freitz85/Victor9000-RAM/README.md

# Victor9000-RAM

The Victor9000-RAM is a modern RAM expansion card for the Victor 9000 computer that extends RAM to the maximum 896k and additionally provides a battery-backed-up real-time clock.

Jumper JP1 open is for use on a 256k motherboard, and JP1 closed is for a 128k motherboard.
