freitz85/Victor9000-RAM/IC_Maxim_DS1315-5+/eec.models/Maxim_-_DS1315-5+.step

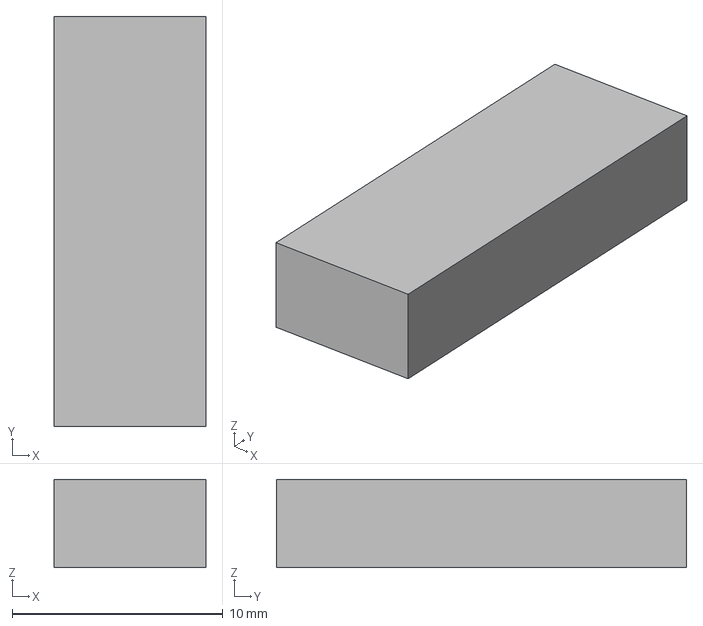
[picture p1: CAD file, 2021-12-12]
IC_Maxim_DS1315-5+/eec.models/Maxim_-_DS1315-5+.step
7.20 x 19.4 x 4.19 mm
