freitz85/Victor9000-RAM/Victor9000-RAM-Clock.pdf

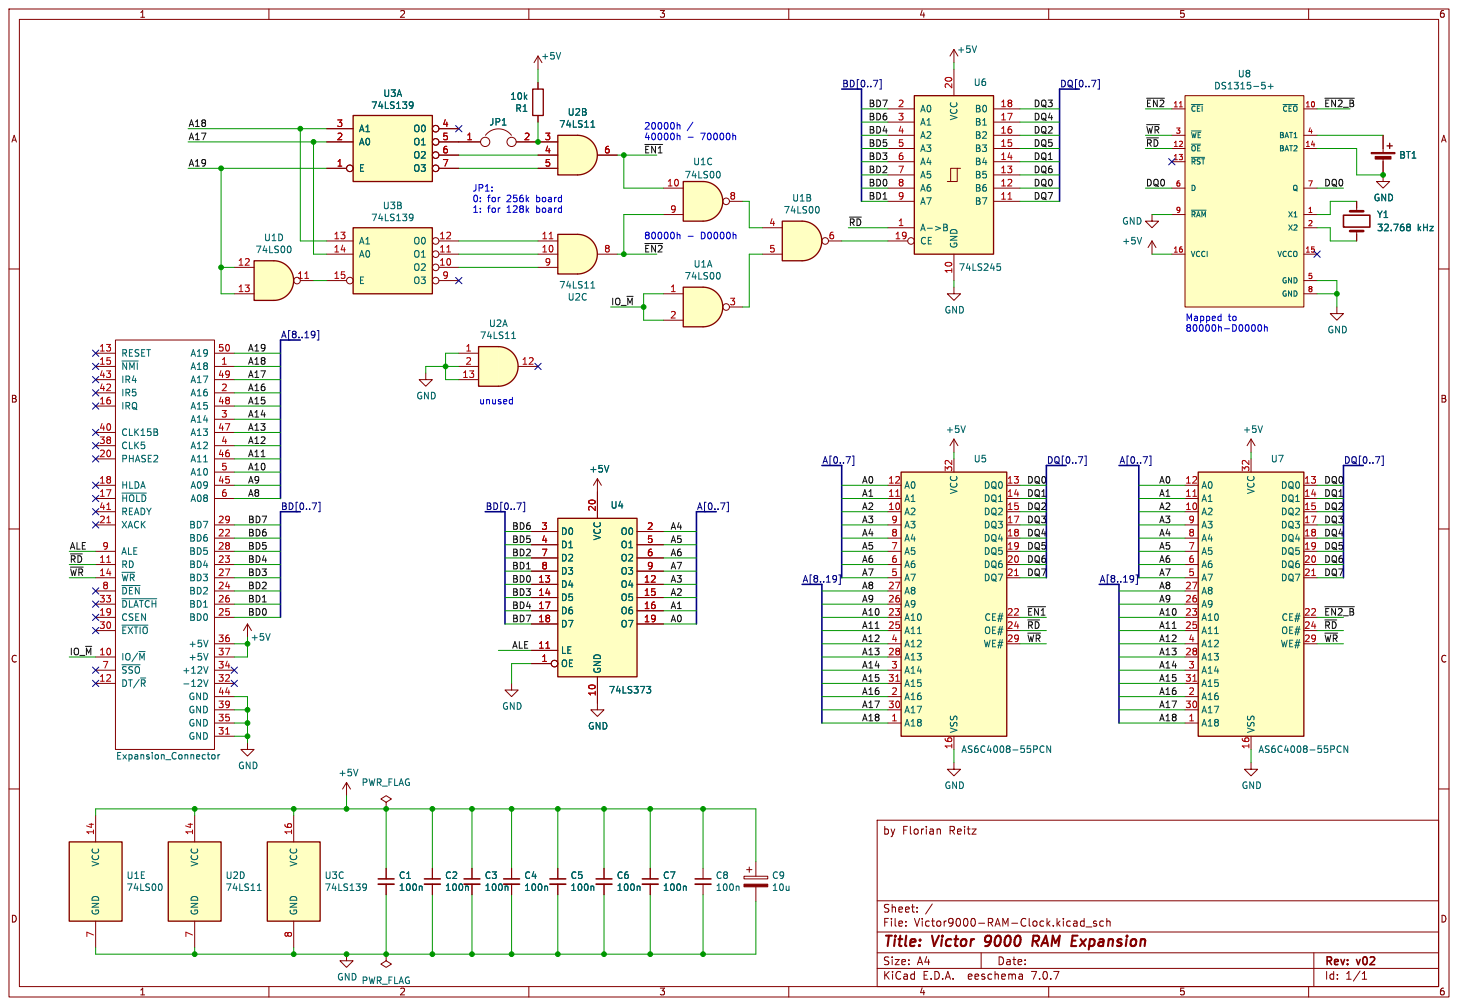
[picture p2: page 1]

IO/~{M} 10 RD 11 DT/~{R} 12 RESET 13 ~{WR} 14 ~{NMI} 15

Id: 1/1 Title: Victor 9000 RAM Expansion
