freitz85/Victor9000-RAM/Victor9000-RAM-Clock.kicad_pcb

## KiCad design Victor9000-RAM-Clock.kicad_pcb (2025-04-15)

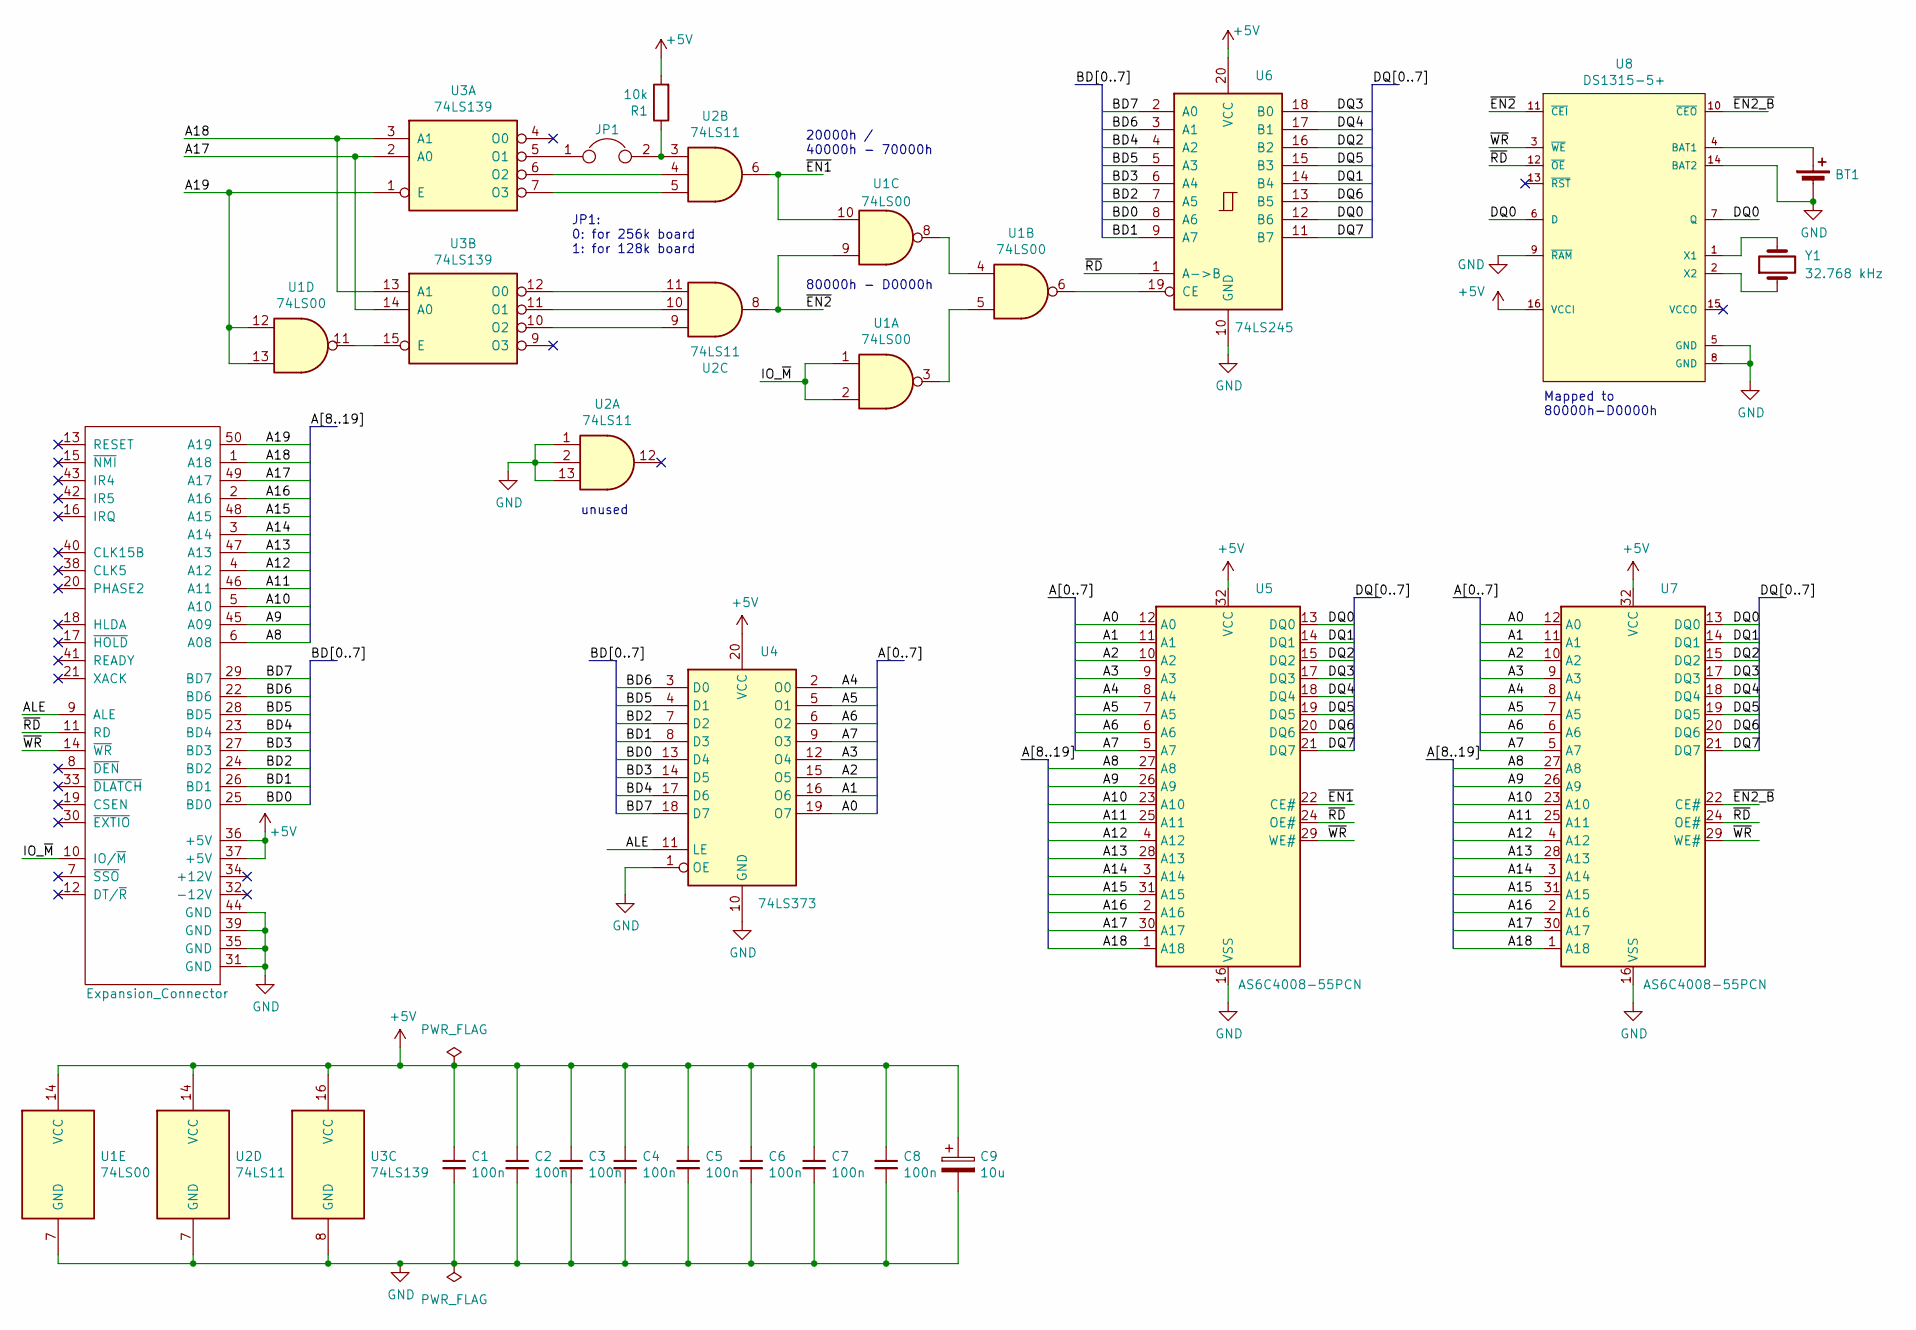
[picture p3: schematic Victor9000-RAM-Clock.kicad_sch, Victor 9000 RAM Expansion]

Parts:
BT1: Battery_Cell; BatteryHolder_Keystone_103_1x20mm
C1, C2, C3, C4, C5, C6, C7, C8: 100n; C_Disc_D5.0mm_W2.5mm_P2.50mm
C9: 10u; CP_Radial_D6.3mm_P2.50mm
H1: Expansion_Connector; Victor Expansion Edge Connector
JP1: Jumper; PinHeader_1x02_P2.54mm_Vertical
R1: 10k; R_Axial_DIN0207_L6.3mm_D2.5mm_P7.62mm_Horizontal
U1: 74LS00; DIP-14_W7.62mm
U2: 74LS11; DIP-14_W7.62mm
U3: 74LS139; DIP-16_W7.62mm
U4: 74LS373; DIP-20_W7.62mm
U5, U7: AS6C4008-55PCN; DIP-32_W15.24mm
U6: 74LS245; DIP-20_W7.62mm
U8: DS1315-5+; Maxim-DS1315-5+-Manufacturer_Recommended
Y1: 32.768 kHz; Crystal_DS26_D2.0mm_L6.0mm_Horizontal

Connections:
+5V: C1.1, C2.1, C3.1, C4.1, C5.1, C6.1, C7.1, C8.1, C9.1, H1.36 (+5V), H1.37 (+5V), R1.2, U1.14 (VCC), U2.14 (VCC), U3.16 (VCC), U4.20 (VCC), U5.32 (VCC), U6.20 (VCC), U7.32 (VCC), U8.16 (VCCI)
/A0: U4.19 (O7), U5.12 (A0), U7.12 (A0)
/A1: U4.16 (O6), U5.11 (A1), U7.11 (A1)
/A2: U4.15 (O5), U5.10 (A2), U7.10 (A2)
/A3: U4.12 (O4), U5.9 (A3), U7.9 (A3)
/A4: U4.2 (O0), U5.8 (A4), U7.8 (A4)
/A5: U4.5 (O1), U5.7 (A5), U7.7 (A5)
/A6: U4.6 (O2), U5.6 (A6), U7.6 (A6)
/A7: U4.9 (O3), U5.5 (A7), U7.5 (A7)
/A8: H1.6 (A08), U5.27 (A8), U7.27 (A8)
/A9: H1.45 (A09), U5.26 (A9), U7.26 (A9)
/A10: H1.5 (A10), U5.23 (A10), U7.23 (A10)
/A11: H1.46 (A11), U5.25 (A11), U7.25 (A11)
/A12: H1.4 (A12), U5.4 (A12), U7.4 (A12)
/A13: H1.47 (A13), U5.28 (A13), U7.28 (A13)
/A14: H1.3 (A14), U5.3 (A14), U7.3 (A14)
/A15: H1.48 (A15), U5.31 (A15), U7.31 (A15)
/A16: H1.2 (A16), U5.2 (A16), U7.2 (A16)
/A17: H1.49 (A17), U3.2 (A0), U3.14 (A0), U5.30 (A17), U7.30 (A17)
/A18: H1.1 (A18), U3.3 (A1), U3.13 (A1), U5.1 (A18), U7.1 (A18)
/A19: H1.50 (A19), U1.12, U1.13, U3.1 (E)
/ALE: H1.9 (ALE), U4.11 (LE)
/BD0: H1.25 (BD0), U4.13 (D4), U6.8 (A6)
/BD1: H1.26 (BD1), U4.8 (D3), U6.9 (A7)
/BD2: H1.24 (BD2), U4.7 (D2), U6.7 (A5)
/BD3: H1.27 (BD3), U4.14 (D5), U6.6 (A4)
/BD4: H1.23 (BD4), U4.17 (D6), U6.4 (A2)
/BD5: H1.28 (BD5), U4.4 (D1), U6.5 (A3)
/BD6: H1.22 (BD6), U4.3 (D0), U6.3 (A1)
/BD7: H1.29 (BD7), U4.18 (D7), U6.2 (A0)
/DQ0: U5.13 (DQ0), U6.12 (B6), U7.13 (DQ0), U8.6 (D), U8.7 (Q)
/DQ1: U5.14 (DQ1), U6.14 (B4), U7.14 (DQ1)
/DQ2: U5.15 (DQ2), U6.16 (B2), U7.15 (DQ2)
/DQ3: U5.17 (DQ3), U6.18 (B0), U7.17 (DQ3)
/DQ4: U5.18 (DQ4), U6.17 (B1), U7.18 (DQ4)
/DQ5: U5.19 (DQ5), U6.15 (B3), U7.19 (DQ5)
/DQ6: U5.20 (DQ6), U6.13 (B5), U7.20 (DQ6)
/DQ7: U5.21 (DQ7), U6.11 (B7), U7.21 (DQ7)
/IO_~M: H1.10 (IO/~M), U1.1, U1.2
/~EN1: U1.10, U2.6, U5.22 (CE#)
/~EN2_B: U7.22 (CE#), U8.10 (~CEO)
/~EN2: U1.9, U2.8, U8.11 (~CEI)
/~RD: H1.11 (RD), U5.24 (OE#), U6.1 (A->B), U7.24 (OE#), U8.12 (~OE)
/~WR: H1.14 (~WR), U5.29 (WE#), U7.29 (WE#), U8.3 (~WE)
GND: BT1.2 (-), C1.2, C2.2, C3.2, C4.2, C5.2, C6.2, C7.2, C8.2, C9.2, H1.31 (GND), H1.35 (GND), H1.39 (GND), H1.44 (GND), U1.7 (GND), U2.1, U2.2, U2.7 (GND), U2.13, U3.8 (GND), U4.1 (OE), U4.10 (GND), U5.16 (VSS), U6.10 (GND), U7.16 (VSS), U8.5 (GND), U8.8 (GND), U8.9 (~RAM), U8.14 (BAT2)
unnamed: BT1.1 (+), U8.4 (BAT1)
unnamed: JP1.2, R1.1, U2.3
unnamed: U1.3, U1.5
unnamed: U1.4, U1.8
unnamed: JP1.1, U3.5 (O1)
unnamed: U2.4, U3.6 (O2)
unnamed: U2.5, U3.7 (O3)
unnamed: U1.11, U3.15 (E)
unnamed: U2.11, U3.12 (O0)
unnamed: U2.10, U3.11 (O1)
unnamed: U2.9, U3.10 (O2)
unnamed: U1.6, U6.19 (CE)
unnamed: U8.1 (X1), Y1.2
unnamed: U8.2 (X2), Y1.1

Notes on the sheet:
unused
80000h - D0000h
JP1: 0: for 256k board 1: for 128k board
20000h / 40000h - 70000h
Mapped to 80000h-D0000h

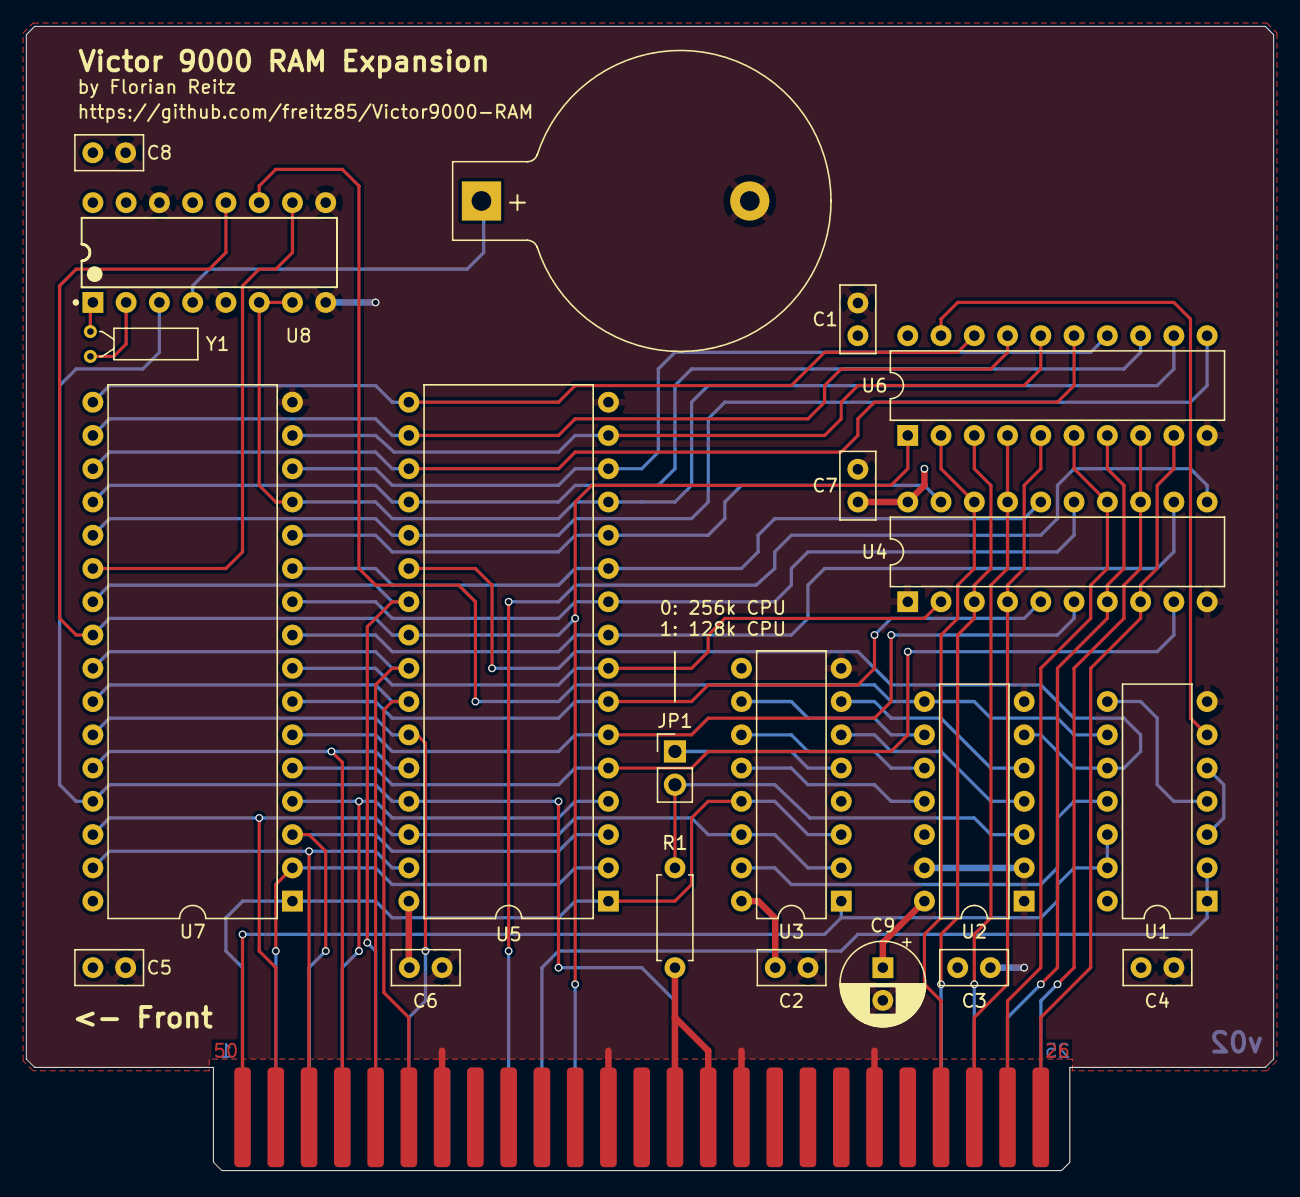
[picture p4: board Victor9000-RAM-Clock.kicad_pcb from above]

Board: 2 copper layers, 95.2 x 87.4 mm, 22 parts (0 on the bottom side), 59 nets.
