freitz85/Victor9000-RAM/(threads)

Thread 1 (2025-04-08):

Hello!/Status of project

drdpj, 2025-04-08:
Hello! I hope you're well. I know this isn't the ideal way of contacting, but I know you've not logged into stardot for ages and I had a couple of questions about these repos:

1) this card, RAM/Clock - is this working? Removing 768k of 4164 ICs from my machine feels like it would probably be beneficial so if this design is tested and functional I'll order some boards and give it a go :)

2) - the v9k RAM test ROM repo you've forked and updated (I can't actually raise any comments on that) My v9k is doing something very strange in the lower memory, it seems fine, the software ram test says it's all fine, but autocad says it can't find free RAM in the right place. I figured a ROM based test might be helpful! Is this just a case of burning the generated binary to a 2564 and putting it in the lower socket?

Best wishes,
Daniel

freitz85, 2025-04-15:
Hi Daniel,
Thank you for reaching out to me about my projects. I have not worked on them for quite some time, and your message finally made me have a look at the RAM card again!
I have corrected the read/write logic to the correct pins and uploaded a revised version V02. My Victor is showing the full 896k on boot now. However, I have not tested the clock yet.

My V9k also has strange RAM issues in the onboard 256k as the FAT on diskettes or hard disk gets corrupted very quickly. I hope to get this resolved once I manage to develop the RAM test further. Currently, I can output a message, but no RAM is tested yet. Hopefully I will find some time to complete it soon.

drdpj, 2025-04-16:
Excellent! :D Right - I shall get a couple made.  The RAM fault is really strange - essentially autocad is claiming that there's no memory at a segment it wants there to be memory at. Also wordperfect keeps asking if another copy is running when I start it... It sounds like an address line error, but when I run the detailed RAM test it doesn't report any issues (I've gone back to dos 1.25 and just the base 128kb on the motherboard). It's very strange - DOS boots fine, lots of things run fine (sometimes there are crashes when returning to the DOS prompt though).

Closed 2025-05-03.
