freitz85/Victor9000-RAM/(commit log)

2021-12-08 Files added
    [Victor9000-RAM-Clock.kicad_pcb, Victor9000-RAM-Clock.sch]
2021-12-12 Routing completed
    [Victor9000-RAM-Clock.kicad_pcb, Victor9000-RAM-Clock.sch]
2021-12-12 DS1315 added
    [Maxim_-_DS1315-5+.step, Victor9000-RAM-Clock.kicad_pcb, Victor9000-RAM-Clock.sch]
2021-12-12 Comments added
    [Victor9000-RAM-Clock.kicad_pcb, Victor9000-RAM-Clock.sch]
2021-12-17 Swapped layers
    [Victor9000-RAM-Clock.kicad_pcb]
2024-05-07 Crystal added
    [Victor9000-RAM-Clock.kicad_pcb, Victor9000-RAM-Clock.kicad_sch]
2025-04-15 Read and write access corrected
    [Victor9000-RAM-Clock.kicad_pcb, Victor9000-RAM-Clock.kicad_sch]
